Aadi-1149/DD-Robocon/WhatsApp Image 2025-07-12 at 10.44.45_70755ee2.jpg

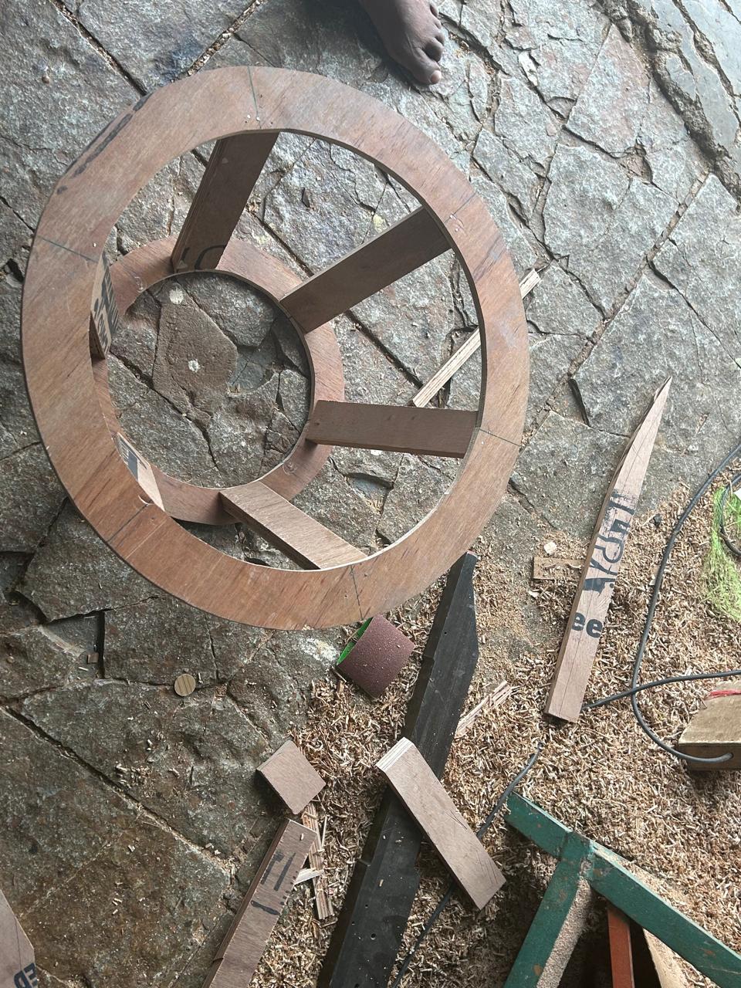
WhatsApp Image 2025-07-12 at 10.44.45_70755ee2.jpg
