Aadi-1149/DD-Robocon/README.md

# DD-Robocon

Basketball receiving mechanism designed with calculations of moment of inertia and center of mass. Multiple iterations were performed in design stage. Arms carry a net that catches the basketball, reducing its Impact force, Arms open via a spring loaded mechanism and close via stepper motors.
