Aadi-1149/DD-Robocon/DD_Robocon_receiving.step

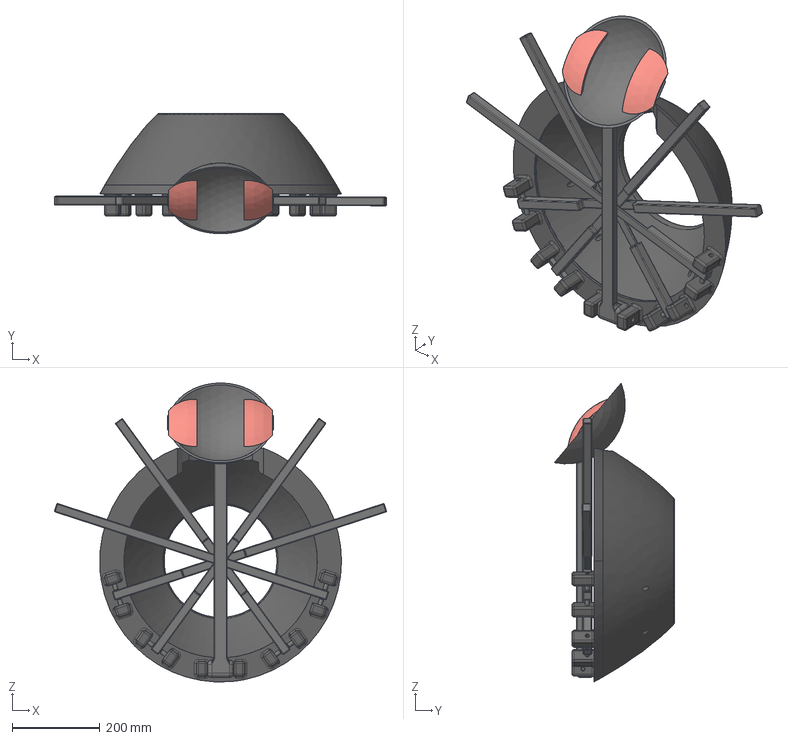
[picture p14: CAD file, 2025-07-12]
DD_Robocon_receiving.step
755.1 x 273.4 x 679.6 mm
Arm3 x 2
Arm4 x 2
Dunk arm
Grips
Grips v4(Mirror)
